h07jonas/SYNCHRO/Hardware/BOM_SYNCHRO.md

|**Name**|**Anzahl**|**Bestellnummer**|**Lieferant**|
|-|-|-|-|
|ESP32-S3-WROOM1-N8R8|1|356-EP32S3WROOM1N8R8|mouser|
|Keramikkondensator 0.1uF X7R 1206|1|77-VJ1206Y104KXXMT|mouser|
|Keramikkondensator 1uF X7R 1206|1|77-VJ1206Y105KLXAJ32|mouser|
|Keramikkondensator 22uF X7R 1210|1|963-MAAST32MSB7226MP|mouser|
|Dickfilmwiderstände SMD 0805 1% 10kOhms 1/8W|2|603-RE0805FRE1010KL|mouser|
|USB 2.0 B Type|1|523-GSB22120RSKEU|mouser|
|DC/DC-Wandler – Durchsteckmontage 3.3V 500mA|1|919-R-78E3.3-0.5|mouser|
|Keramikkondensator 10uF X7R 1210|1|963-TMK325AB7106KMPR|mouser|
|Leitungstreiber Non-inverting Octal Bus|2|863-C74VHCT541ADWR2G|mouser|
|DC/DC-Wandler – Durchsteckmontage 8-28Vin 5V 1.0A THRU|1|919-R-78E5.0-1.0|mouser|
|AC-Adapter 12V 1A|1|490-SWI12-12-E-P5|mouser|
|DC-Spannungsversorgungssteckverbinder|1|710-694106301002|mouser|
|LDO Spannungs-Regulator LDO BJT HiCurr 3.3V 1A|1|621-AZ1117CH-3.3TRG1|mouser|
|Schottky Diode|1|771-PMEG3010ER-QX|mouser|
|XH Header Sockel|8|306-B4BXHALFSN|mouser|
