h07jonas/SYNCHRO/Docs/BOM_SYNCHRO_Booster.xlsx

Projekt: | SYNCHRO | Baugruppe: | Booster | Baugruppennr.: | 1.0
Ersteller: | Jonas Henz | Revision: | v1.0 | Status: | Entwurf
Anzahl Baugruppen: | 6 | Datum: | 2026-08-25
Reference | Qty | Gesamtmenge | Bestellmenge | Bestellnummer | Link | Lieferant | Value | Footprint | Datasheet
C1,C9,C10,C11,C12 | 5 | 30 | 40 | 77-VJ1206Y104KXXMT | https://www.mouser.ch/en/ProductDetail/Vishay-Vitramon/VJ1206Y104KXXMT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 | Mouser | Capacitor_THT:C_Disc_D5.0mm_W2.5mm_P5.00mm | Capacitor_THT:C_Disc_D5.0mm_W2.5mm_P5.00mm
C2,C3 | 2 | 12 | 15 | 667-EEU-FM1V471 | https://www.mouser.ch/en/ProductDetail/Panasonic-Industry/EEU-FM1V471?qs=4F1vP4lJYtGxZCTadysVhQ%3D%3D | Mouser | Capacitor_THT:CP_Radial_D10.0mm_P5.00mm | Capacitor_THT:CP_Radial_D10.0mm_P5.00mm
C4 | 1 | 6 | 10 | 80-C317C103K1R | https://www.mouser.ch/en/ProductDetail/KEMET/C317C103K1R5TA?qs=wGiHhy9sa2PnfI8By%252BZbyA%3D%3D | Mouser | Capacitor_THT:C_Disc_D5.0mm_W2.5mm_P5.00mm | Capacitor_THT:C_Disc_D5.0mm_W2.5mm_P5.00mm
C5,C6,C7 | 3 | 18 | 20 | 505-MKS20.022/63/5 | https://www.mouser.ch/en/ProductDetail/WIMA/MKS2C022201A00JSSD?qs=ISKKXg98%252B1kXZo2DGjqt1Q%3D%3D | Mouser | Capacitor_THT:C_Rect_L7.0mm_W2.5mm_P5.00mm | Capacitor_THT:C_Rect_L7.0mm_W2.5mm_P5.00mm
C8 | 1 | 6 | 10 | 667-EEU-HD1H100B | https://www.mouser.ch/en/ProductDetail/Panasonic-Industry/EEU-HD1H100B?qs=RSvpxwwo2RNa75zii2se%2FA%3D%3D | Mouser | Capacitor_THT:C_Rect_L7.0mm_W2.5mm_P5.00mm | Capacitor_THT:C_Rect_L7.0mm_W2.5mm_P5.00mm
D1,D2 | 2 | 12 | 20 | 512-1N4148 | https://www.mouser.ch/en/ProductDetail/onsemi/1N4148?qs=i4Fj9T%2FoRm8RMUhj5DeFQg%3D%3D | Mouser | Diode_THT:D_DO-35_SOD27_P7.62mm_Horizontal | Diode_THT:D_DO-35_SOD27_P7.62mm_Horizontal | https://assets.nexperia.com/documents/data-sheet/1N4148_1N4448.pdf
D3 | 1 | 6 | 10 | 625-SMAJ16CA-E3 | https://www.mouser.ch/en/ProductDetail/Vishay-Semiconductors/SMAJ16CA-E3-61?qs=nE2yEqgPWzdYDq2yTw6oFA%3D%3D | Mouser | Diode_SMD:D_SMA-SMB_Universal_Handsoldering | Diode_SMD:D_SMA-SMB_Universal_Handsoldering | https://www.littelfuse.com/media?itemid=75e32973-b177-4ee3-a0ff-cedaf1abdb93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
D4,D5 | 2 | 12 | x | vorhanden |  |  | LED_THT:LED_D5.0mm | LED_THT:LED_D5.0mm
F1 | 1 | 6 | 10 | 652-MFR185 | https://www.mouser.ch/en/ProductDetail/Bourns/MF-R185?qs=2bTIwLLrckQD2gvRTyQH8A%3D%3D | Mouser | SYNCHRO_Library:Fuse_Bourns_MF-R185 | SYNCHRO_Library:Fuse_Bourns_MF-R185
IC1 | 1 | 6 | 6 | 511-L6203 | https://www.mouser.ch/en/ProductDetail/STMicroelectronics/L6203?qs=gr8Zi5OG3MivQB7QgTa84w%3D%3D | Mouser | SYNCHRO_Library:MULTIWATT-11 | SYNCHRO_Library:MULTIWATT-11
J1,J2 | 2 | 12 | 12 | 651-1711725 | https://www.mouser.ch/en/ProductDetail/Phoenix-Contact/1711725?qs=F79NelsxgYFLEb9U5DotcA%3D%3D | Mouser | TerminalBlock_Phoenix:TerminalBlock_Phoenix_MKDS-1,5-2-5.08_1x02_P5.08mm_Horizontal | TerminalBlock_Phoenix:TerminalBlock_Phoenix_MKDS-1,5-2-5.08_1x02_P5.08mm_Horizontal
J3 | 1 | 6 | 20 | 306-B4BXHALFSN | https://www.mouser.ch/en/ProductDetail/JST-Commercial/B4B-XH-ALFSN?qs=cdbOS8ANM9CfC08d%252BywhFw%3D%3D | Mouser | SYNCHRO_Library:JST_B4B-XH-A_LF__SN_ | SYNCHRO_Library:JST_B4B-XH-A_LF__SN_
J4 | 1 | 6 | x | vorhanden |  |  | Messpunkt | Messpunkt
PS1 | 1 | 6 | 8 | 919-R-78E5.0-0.5 | https://www.mouser.ch/en/ProductDetail/RECOM-Power/R-78E5.0-0.5?qs=JeAkOuORR2UvBuiB2kZVZQ%3D%3D | Mouser | SYNCHRO_Library:CONV_R-78E5.0-0.5 | SYNCHRO_Library:CONV_R-78E5.0-0.5
R1 | 1 | 6 | 10 | 756-LRMAP2512R10FT4 | https://www.mouser.ch/en/ProductDetail/Welwyn-Components-TT-Electronics/LRMAP2512-R10FT4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 | Mouser | Resistor_SMD:R_2512_6332Metric_Pad1.40x3.35mm_HandSolder | Resistor_SMD:R_2512_6332Metric_Pad1.40x3.35mm_HandSolder | LRMAP2512-R10FT4.
R2,R4,R12,R13 | 4 | 24 | x | vorhanden |  |  | Resistor_SMD:R_0805_2012Metric_Pad1.20x1.40mm_HandSolder | Resistor_SMD:R_0805_2012Metric_Pad1.20x1.40mm_HandSolder
R3 | 1 | 6 | x | vorhanden |  |  | Resistor_SMD:R_0805_2012Metric_Pad1.20x1.40mm_HandSolder | Resistor_SMD:R_0805_2012Metric_Pad1.20x1.40mm_HandSolder
R5,R9,R10 | 3 | 18 | x | vorhanden |  |  | Resistor_SMD:R_0805_2012Metric_Pad1.20x1.40mm_HandSolder | Resistor_SMD:R_0805_2012Metric_Pad1.20x1.40mm_HandSolder
R6 | 1 | 6 | x | vorhanden |  |  | Resistor_SMD:R_0805_2012Metric_Pad1.20x1.40mm_HandSolder | Resistor_SMD:R_0805_2012Metric_Pad1.20x1.40mm_HandSolder
R7,R8 | 2 | 12 | x | vorhanden |  |  | Resistor_SMD:R_0805_2012Metric_Pad1.20x1.40mm_HandSolder | Resistor_SMD:R_0805_2012Metric_Pad1.20x1.40mm_HandSolder
R11 | 1 | 6 | x | vorhanden |  |  | Resistor_SMD:R_0805_2012Metric_Pad1.20x1.40mm_HandSolder | Resistor_SMD:R_0805_2012Metric_Pad1.20x1.40mm_HandSolder
SW1 | 1 | 6 | x | vorhanden |  |  | Button_Switch_THT:SW_PUSH_6mm | Button_Switch_THT:SW_PUSH_6mm
SW2 | 1 | 6 | 6 | 651-1711738 | https://www.mouser.ch/en/ProductDetail/Phoenix-Contact/1711738?qs=F79NelsxgYGJoCQSSUE92w%3D%3D | Mouser | TerminalBlock_Phoenix:TerminalBlock_Phoenix_MKDS-3-3-5.08_1x03_P5.08mm_Horizontal | TerminalBlock_Phoenix:TerminalBlock_Phoenix_MKDS-3-3-5.08_1x03_P5.08mm_Horizontal
U1 | 1 | 6 | 10 | 595-LM393P | https://www.mouser.ch/en/ProductDetail/Texas-Instruments/LM393P?qs=1K8%2FAQHn5WT5g4otW1rg%2Fg%3D%3D | Mouser | SYNCHRO_Library:DIP762W50P254L977H451Q8 | SYNCHRO_Library:DIP762W50P254L977H451Q8
U2,U3 | 2 | 12 | 20 | 859-6N137 | https://www.mouser.ch/en/ProductDetail/LITEON/6N137?qs=PByDJ0nQNwo227Fz%2Fg9MJA%3D%3D | Mouser | SYNCHRO_Library:DIP762W50P254L977H451Q8 | SYNCHRO_Library:DIP762W50P254L977H451Q8
U4 | 1 | 6 | 10 | 771-LVC2G02DC125 | https://www.mouser.ch/en/ProductDetail/Nexperia/74LVC2G02DC125?qs=me8TqzrmIYUWhTHaIlO9Yw%3D%3D | Mouser | Package_SO:VSSOP-8_2.3x2mm_P0.5mm | Package_SO:VSSOP-8_2.3x2mm_P0.5mm | http://www.ti.com/lit/sg/scyt129e/scyt129e.pdf
 |  |  |  |  |  | Gesamtpreis pro Baugruppe: | 0
 |  |  |  |  |  | Gesamtpreis Total: | 0
