h07jonas/SYNCHRO/Docs/SYNCHRO_BOM_Zentrale_Booster.xlsx

Sheet: SYNCHRO Zentrale
SYNCHRO Zentrale – Modul-Stückliste
Projekt: SYNCHRO Zentrale | 0805 SMD-Widerstände zusammengefasst | Mouser Bestellnummern & Richtpreise
Pos | Designator | Menge | Wert / Typ | Beschreibung | Bauform / Gehäuse | Mouser Bestellnummer | Hersteller-Teilenummer | Stückpreis (CHF) | Gesamtpreis (CHF) | Lieferant
1 | U1 | 1 | ESP32-S3-WROOM-1-N8R8 | Mikrocontroller Modul Wi-Fi / BLE (8MB Flash, 8MB PSRAM) | SMD Modul | 356-EP32S3WROOM1N8R8 | ESP32-S3-WROOM-1-N8R8 | 5.40 CHF |  | Mouser
2 | IC1, IC2 | 2 | MC74VHCT541ADWR2G | Octal Bus Buffer / Line Driver Non-Inverting 3-State | SOIC-20 | 863-C74VHCT541ADWR2G | MC74VHCT541ADWR2G | 0.96 CHF |  | Mouser
3 | IC3 | 1 | AZ1117CH-3.3TRG1 | LDO Spannungsregler 3.3V 1A | SOT-223 | 621-AZ1117CH-3.3TRG1 | AZ1117CH-3.3TRG1 | 0.48 CHF |  | Mouser
4 | PS1 | 1 | R-78E3.3-0.5 | DC/DC-Schaltregler 3.3V 500mA SIP-3 | SIP-3 THT | 919-R-78E3.3-0.5 | R-78E3.3-0.5 | 2.65 CHF |  | Mouser
5 | PS2 | 1 | R-78E5.0-1.0 | DC/DC-Schaltregler 5.0V 1.0A SIP-3 | SIP-3 THT | 919-R-78E5.0-1.0 | R-78E5.0-1.0 | 3.41 CHF |  | Mouser
6 | D1 | 1 | PMEG3010ER | Schottky-Diode 30V 1A Low Vf | SOD-123W (CFP3) | 771-PMEG3010ER-QX | PMEG3010ER,115 | 0.38 CHF |  | Mouser
7 | D2, D3, D4, D5, D6, D7 | 6 | LED | Standard Signal-LED 5mm THT | LED 5.0mm Radial | 604-WP7113GD | WP7113GD | 0.28 CHF |  | Mouser
8 | C1, C12 | 2 | 22uF | Keramikkondensator 22µF 16V/25V X7R | 1210 SMD | 963-MAAST32MSB7226MP | EMK325B7226MM-TR | 0.85 CHF |  | Mouser
9 | C2, C4, C7, C8 | 4 | 100nF / 0.1uF | Keramikkondensator 100nF 50V X7R | 1206 SMD | 77-VJ1206Y104KXXMT | VJ1206Y104KXXMT | 0.22 CHF |  | Mouser
10 | C3 | 1 | 1uF | Keramikkondensator 1µF 50V X7R | 1206 SMD | 77-VJ1206Y105KLXAJ32 | VJ1206Y105KLXAJ32 | 0.35 CHF |  | Mouser
11 | C5, C6, C9, C10, C11 | 5 | 10uF | Keramikkondensator 10µF 25V X7R | 1210 SMD | 963-TMK325AB7106KMPR | TMK325AB7106KMPR | 0.65 CHF |  | Mouser
12 | R1 .. R12 | 12 | 0805 SMD Widerstände | SMD-Widerstände 0805 1% (6x 10k, 5x 220R, 1x 470R) | 0805 SMD | 603-RC0805FR-Serie | RC0805FR-Serie | 0.08 CHF |  | Mouser
13 | SW1, SW2, SW3, SW4, SW5, SW6 | 6 | SW_Push | Kurzhubtaster 6x6mm THT H=4.3mm/5mm | Button 6x6mm THT | 688-SKHHBY004A | SKHHBY004A | 0.32 CHF |  | Mouser
14 | J1 | 1 | GSB22120RSKEU | USB 2.0 Typ-B Buchse Printmontage | USB-B THT | 523-GSB22120RSKEU | GSB22120RSKEU | 1.45 CHF |  | Mouser
15 | J2, J3, J4, J5, J6, J7, J8, J9 | 8 | B4B-XH-A_LF__SN_ | JST XH Stiftwanne 4-polig RM 2.50mm | JST XH 4-Pin RM 2.50mm | 306-B4BXHALFSN | B4B-XH-A(LF)(SN) | 0.25 CHF |  | Mouser
16 | J10 | 1 | 694106301002 | DC-Hohlstecker-Buchse 2.1mm / 5.5mm | DC-Power Jack 2.1mm | 710-694106301002 | 694106301002 | 1.10 CHF |  | Mouser
17 | J11 | 1 | Conn_01x06 | Stiftleiste 1x6-polig RM 2.54mm gerade | Pin Header 1x06 RM2.54 | 517-961106-6404-AR | 961106-6404-AR | 0.45 CHF |  | Mouser
18 | Zubehör | 1 | SWI12-12-E-P5 | AC/DC Steckernetzteil 12V 1A Eurostecker (Zubehör) | Wall Adapter | 490-SWI12-12-E-P5 | SWI12-12-E-P5 | 11.20 CHF |  | Mouser
TOTAL ZENTRALE:

Sheet: SYNCHRO Booster
SYNCHRO Booster – Modul-Stückliste
Projekt: SYNCHRO Booster | 0805 SMD-Widerstände zusammengefasst | Mouser Bestellnummern & Richtpreise
Pos | Designator | Menge | Wert / Typ | Beschreibung | Bauform / Gehäuse | Mouser Bestellnummer | Hersteller-Teilenummer | Stückpreis (CHF) | Gesamtpreis (CHF) | Lieferant
1 | IC1 | 1 | L6203 | DMOS Vollbrücken-Treiber 4A 52V | MULTIWATT-11 | 511-L6203 | L6203 | 9.94 CHF |  | Mouser
2 | U1 | 1 | LM393P | Dualer Komparator Low-Power | DIP-8 | 595-LM393P | LM393P | 0.65 CHF |  | Mouser
3 | U2, U3 | 2 | 6N137 | High-Speed Optokoppler 10 MBd Open-Collector | DIP-8 | 782-6N137 | 6N137 | 1.15 CHF |  | Mouser
4 | U4 | 1 | 74LVC2G02 | Dual 2-Input NOR-Gatter (SN74LVC2G02DCUR) | VSSOP-8 | 595-SN74LVC2G02DCUR | SN74LVC2G02DCUR | 0.45 CHF |  | Mouser
5 | PS1 | 1 | R-78E5.0-0.5 | DC/DC-Schaltregler 5.0V 500mA SIP-3 | SIP-3 THT | 919-R-78E5.0-0.5 | R-78E5.0-0.5 | 2.65 CHF |  | Mouser
6 | D1, D2 | 2 | 1N4148 | Standard-Schaltdiode 100V 200mA | DO-35 THT | 512-1N4148 | 1N4148 | 0.12 CHF |  | Mouser
7 | D3 | 1 | SMAJ16CA-E3/61 | TVS-Diode Bidirektional 16V 400W | SMA (DO-214AC) | 625-SMAJ16CA-E3/61 | SMAJ16CA-E3/61 | 0.42 CHF |  | Mouser
8 | D4, D5 | 2 | LED | Standard Signal-LED 5mm THT | LED 5.0mm Radial | 604-WP7113GD | WP7113GD | 0.28 CHF |  | Mouser
9 | F1 | 1 | MF-R185-2-99 | PTC-Sicherung PolySwitch rückstellbar 1.85A | Radial THT | 652-MF-R185-2-99 | MF-R185-2-99 | 0.85 CHF |  | Mouser
10 | C1, C9..C12 | 5 | 100nF | Keramikkondensator 100nF 50V X7R THT | Radial D5.0mm RM5.0 | 80-C315C104K5R5TA | C315C104K5R5TA | 0.25 CHF |  | Mouser
11 | C2, C3 | 2 | 470uF | Elektrolytkondensator Radial 470µF 35V Low-ESR | Radial D10mm RM5.0 | 667-EEU-FR1V471 | EEU-FR1V471 | 0.72 CHF |  | Mouser
12 | C4 | 1 | 10nF | Keramikkondensator 10nF 50V X7R THT | Radial D5.0mm RM5.0 | 80-C315C103K5R5TA | C315C103K5R5TA | 0.20 CHF |  | Mouser
13 | C5, C6, C7 | 3 | 22nF 50V | Folienkondensator MKS 22nF 63V/50V RM5.0 | Rect THT RM5.0 | 505-MKS20.022/63/10 | MKS2C022201A00KSSD | 0.55 CHF |  | Mouser
14 | C8 | 1 | 10uF 50V | Folienkondensator / MLCC 10µF 50V RM5.0 | Rect THT RM5.0 | 80-C330C106M5U5TA | C330C106M5U5TA | 0.95 CHF |  | Mouser
15 | R1 | 1 | 100m | Shunt-Messwiderstand 100mΩ 1% 2W SMD 2512 | 2512 SMD | 71-LRMAP2512-R10FT4 | LRMAP2512-R10FT4 | 0.95 CHF |  | Mouser
16 | R2 .. R13 | 11 | 0805 SMD Widerstände | SMD-Widerstände 0805 1% (4x 1k, 1x 24k, 3x 4.7k, 1x 10R, 2x 1.2k, 1x 10k) | 0805 SMD | 603-RC0805FR-Serie | RC0805FR-Serie | 0.08 CHF |  | Mouser
17 | SW1 | 1 | SW_Push | Kurzhubtaster 6x6mm THT H=4.3mm/5mm | Button 6x6mm THT | 688-SKHHBY004A | SKHHBY004A | 0.32 CHF |  | Mouser
18 | SW2 | 1 | SW_SPDT | Phoenix Schraubklemme 3-polig RM 5.08mm | Terminal Block RM 5.08mm | 651-1711738 | 1711738 | 1.35 CHF |  | Mouser
19 | J1, J2 | 2 | Conn_01x02_Pin / Power | Phoenix Schraubklemme 2-polig RM 5.08mm | Terminal Block RM 5.08mm | 651-1715721 | 1715721 | 0.95 CHF |  | Mouser
20 | J3 | 1 | B4B-XH-A | JST XH Stiftwanne 4-polig RM 2.50mm | JST XH 4-Pin RM 2.50mm | 306-B4BXHALFSN | B4B-XH-A(LF)(SN) | 0.25 CHF |  | Mouser
21 | J4 | 1 | Messpunkt | Prüfpunkt / Test Point PCB Miniatur THT | Test Point THT | 534-5001 | 5001 | 0.35 CHF |  | Mouser
TOTAL BOOSTER:
