h07jonas/SYNCHRO/Hardware/SYNCHRO_Zentrale/BOM_SYNCHRO_Zentrale.xlsx

Reference | Qty | Bestellnummer | Lieferant | Value | Footprint | Datasheet
C1,C12 | 2 | 963-MAAST32MSB7226MP | Mouser | Capacitor_SMD:C_1210_3225Metric_Pad1.33x2.70mm_HandSolder | Capacitor_SMD:C_1210_3225Metric_Pad1.33x2.70mm_HandSolder
C2,C4 | 2 | 77-VJ1206Y104KXXMT | Mouser | Capacitor_SMD:C_1206_3216Metric_Pad1.33x1.80mm_HandSolder | Capacitor_SMD:C_1206_3216Metric_Pad1.33x1.80mm_HandSolder
C3 | 1 | 77-VJ1206Y105KLXAJ32 | Mouser | Capacitor_SMD:C_1206_3216Metric_Pad1.33x1.80mm_HandSolder | Capacitor_SMD:C_1206_3216Metric_Pad1.33x1.80mm_HandSolder
C5,C6,C9,C10,C11 | 5 | 963-TMK325AB7106KMPR | Mouser | Capacitor_SMD:C_1210_3225Metric_Pad1.33x2.70mm_HandSolder | Capacitor_SMD:C_1210_3225Metric_Pad1.33x2.70mm_HandSolder
C7,C8 | 2 | 77-VJ1206Y104KXXMT | Mouser | Capacitor_SMD:C_1206_3216Metric_Pad1.33x1.80mm_HandSolder | Capacitor_SMD:C_1206_3216Metric_Pad1.33x1.80mm_HandSolder
D1 | 1 | 771-PMEG3010ER-QX | Mouser | Diode_SMD:Nexperia_CFP3_SOD-123W | Diode_SMD:Nexperia_CFP3_SOD-123W
IC1,IC2 | 2 | 863-C74VHCT541ADWR2G | Mouser | SYNCHRO_Library:SOIC127P1030X265-20N | SYNCHRO_Library:SOIC127P1030X265-20N | https://www.onsemi.com/pub/Collateral/MC74VHC541-D.PDF
IC3 | 1 | 621-AZ1117CH-3.3TRG1 | Mouser | SYNCHRO_Library:SOT230P700X180-4N | SYNCHRO_Library:SOT230P700X180-4N | https://www.diodes.com//assets/Datasheets/AZ1117C.pdf
J1 | 1 | 523-GSB22120RSKEU | Mouser | SYNCHRO_Library:AMPHENOL_GSB22120RSKEU | SYNCHRO_Library:AMPHENOL_GSB22120RSKEU
J2,J3,J4,J5,J6,J7,J8,J9 | 8 | 306-B4BXHALFSN | Mouser | SYNCHRO_Library:JST_B4B-XH-A_LF__SN_ | SYNCHRO_Library:JST_B4B-XH-A_LF__SN_
J10 | 1 | 710-694106301002 | Mouser | SYNCHRO_Library:694106301002 | SYNCHRO_Library:694106301002 | https://www.we-online.com/catalog/datasheet/694106301002.pdf
J11 | 1 |  |  | Conn_01x06 | Conn_01x06
PS1 | 1 | 919-R-78E3.3-0.5 | Mouser | SYNCHRO_Library:CONV_R-78E3.3-0.5 | SYNCHRO_Library:CONV_R-78E3.3-0.5
PS2 | 1 | 919-R-78E5.0-1.0 | Mouser | SYNCHRO_Library:R78E5010 | SYNCHRO_Library:R78E5010 | http://www.recom-power.com/pdf/Innoline/R-78Exx-1.0.pdf
U1 | 1 | 356-EP32S3WROOM1N8R8 | Mouser | SYNCHRO_Library:ESP32S3WROOM1N8R8 | SYNCHRO_Library:ESP32S3WROOM1N8R8
R1,R2,R3,R4,R5,R6 | 6 |  |  | Resistor_SMD:R_0805_2012Metric_Pad1.20x1.40mm_HandSolder | Resistor_SMD:R_0805_2012Metric_Pad1.20x1.40mm_HandSolder
R7,R8,R9,R10,R11 | 5 |  |  | Resistor_SMD:R_0805_2012Metric_Pad1.20x1.40mm_HandSolder | Resistor_SMD:R_0805_2012Metric_Pad1.20x1.40mm_HandSolder
R12 | 1 |  |  | Resistor_SMD:R_0805_2012Metric_Pad1.20x1.40mm_HandSolder | Resistor_SMD:R_0805_2012Metric_Pad1.20x1.40mm_HandSolder
SW1,SW2,SW3,SW4,SW5,SW6 | 6 |  |  | Button_Switch_THT:SW_PUSH_6mm | Button_Switch_THT:SW_PUSH_6mm
D2,D3,D4,D5,D6,D7 | 6 |  |  | LED_THT:LED_D5.0mm | LED_THT:LED_D5.0mm
 |  |  |  |  | Gesamtpreis pro Baugruppe: | 0
 |  |  |  |  | Gesamtpreis Total: | 0
 |  |  |  |  | Projekt: | SYNCHRO | Baugruppe: | DNP | Baugruppennr.: | Zentrale
 |  |  |  |  | Ersteller: | Jonas Henz | Revision: | v1.0 | Status: | Entwurf
 |  |  |  |  | Anzahl Baugruppen: | 1 | Datum: | 2026-08-25
