h07jonas/SYNCHRO/Docs/SYNCHRO_Projekt_Gesamtkosten_Kalkulation.xlsx

SYNCHRO Modellbahnsteuerung – Gesamtkostenkalkulation
Projektumfang: 1x Zentrale, 5x Standard-Booster, 1x Prototyp-Booster | Inkl. Leiterplatten, Gehäuse & Stromversorgung
Pos | Kategorie / Hauptkomponente | Beschreibung & Enthaltene Komponenten | Menge | Einheit | Geschätzter Richtpreis | Gesamtbetrag | Lieferant / Quelle
1.0 SYNCHRO ZENTRALE (1 Stück)
1.1 | Haupt-Mikrocontroller | ESP32-S3-WROOM-1-N8R8 (8MB Flash, 8MB PSRAM) | 1 | Stk. | 6.00 CHF | 6.00 CHF | Mouser
1.2 | Logik & Bus-Treiber | 2x MC74VHCT541A Octal Buffer SOIC-20 | 1 | Satz | 2.50 CHF | 2.50 CHF | Mouser
1.3 | Spannungsversorgung Platine | R-78E5.0-1.0, R-78E3.3-0.5, AZ1117 LDO, Schottky-Diode | 1 | Satz | 8.00 CHF | 8.00 CHF | Mouser
1.4 | Kondensatoren & Passivbauteile | 14x Keramikkondensatoren (1206/1210: 22µF, 10µF, 1µF, 100nF) | 1 | Satz | 6.50 CHF | 6.50 CHF | Mouser
1.5 | SMD-Widerstände 0805 | 12x SMD-Widerstände 0805 1% (10k, 220R, 470R) | 1 | Satz | 1.50 CHF | 1.50 CHF | Mouser
1.6 | Steckverbinder, Taster & LEDs | 8x JST-XH 4-Pin, USB-B Buchse, DC-Buchse, 6x Taster, 6x LEDs, Stiftleiste | 1 | Satz | 8.50 CHF | 8.50 CHF | Mouser
1.7 | Zentrale-Netzteil (Zubehör) | CUI 12V 1A AC/DC Steckernetzteil (Eurostecker) | 1 | Stk. | 12.00 CHF | 12.00 CHF | Mouser
2.0 SYNCHRO STANDARD-BOOSTER (5 Stück)
2.1 | H-Brücken Leistungstreiber | 5x L6203 DMOS Vollbrücken-Treiber 4A 52V (MULTIWATT-11) | 5 | Stk. | 10.50 CHF | 52.50 CHF | Mouser
2.2 | Kühlkörper Leistungstreiber | 5x Aufsteckkühlkörper für Multiwatt-11 Gehäuse | 5 | Stk. | 2.00 CHF | 10.00 CHF | Mouser / Distrelec
2.3 | Optokoppler & Komparator Logik | 10x 6N137 High-Speed Optokoppler, 5x LM393, 5x 74LVC2G02 | 5 | Satz | 4.00 CHF | 20.00 CHF | Mouser
2.4 | Booster Stromversorgung Platine | 5x R-78E5.0-0.5 DC/DC-Schaltregler, TVS- & Schutzdioden | 5 | Satz | 4.00 CHF | 20.00 CHF | Mouser
2.5 | Kondensatoren & Elkos | 10x 470µF Elkos, 25x 100nF THT, Folienkondensatoren (22nF, 10µF) | 5 | Satz | 5.00 CHF | 25.00 CHF | Mouser
2.6 | Widerstände & Shunts | 5x 100mΩ 2512 Shunts + 55x SMD-Widerstände 0805 (10R bis 24k) | 5 | Satz | 2.00 CHF | 10.00 CHF | Mouser
2.7 | Klemmen, PTCs, Taster & LEDs | 10x Phoenix 2p, 5x Phoenix 3p, 5x JST-XH, 5x PTC 1.85A, Taster & LEDs | 5 | Satz | 5.00 CHF | 25.00 CHF | Mouser
3.0 SPEZIELLER BOOSTER PROTOTYP (1 Stück)
3.1 | Prototyp-Bauteilsatz | Komplettsatz Bauteile (Leistungstreiber, Optokoppler, Passiv, Klemmen, Kühlkörper) | 1 | Satz | 32.00 CHF | 32.00 CHF | Mouser
4.0 LEITERPLATTEN-FERTIGUNG (PCB Batches)
4.1 | PCB Zentrale (Batch 5 Stk.) | 2-Layer FR4 1.6mm HASL lead-free (1 verwendet, 4 Reserve) | 1 | Batch | 4.00 CHF | 4.00 CHF | JLCPCB / PCBWay
4.2 | PCB Booster (Batch 5 Stk.) | 2-Layer FR4 1.6mm HASL lead-free (5 verwendet) | 1 | Batch | 4.00 CHF | 4.00 CHF | JLCPCB / PCBWay
4.3 | PCB Prototyp (Batch 5 Stk.) | 2-Layer FR4 1.6mm HASL lead-free (1 verwendet, 4 Reserve) | 1 | Batch | 4.00 CHF | 4.00 CHF | JLCPCB / PCBWay
4.4 | Express-Versand & Verzollung PCBs | Kombinierter DHL Express Versand + Einfuhr/Handling Schweiz | 1 | Pauschal | 24.00 CHF | 24.00 CHF | Spediteur / DHL
5.0 HAUPTSTROMVERSORGUNG & GEHÄUSE (3D-DRUCK)
5.1 | Gleisstrom-Hauptnetzteil | MeanWell LRS-350-15 Schaltnetzteil (15V DC / 23.2A / 350W) | 1 | Stk. | 35.00 CHF | 35.00 CHF | Mouser / Distrelec
5.2 | 3D-Druck Gehäuse (PLA) | 7x Gehäuseunterteil & Deckel (ca. 550g PLA Filament) | 1 | Pauschal | 16.00 CHF | 16.00 CHF | Filamentbestand
5.3 | 3D-Druck Frontblenden (Resin) | 7x Frontplatten / Lichtleiter / Tasterführungen (ca. 200ml Resin) | 1 | Pauschal | 10.00 CHF | 10.00 CHF | Resinbestand
5.4 | Montagematerial & Puffer | Schrauben M3/M2.5, Gummifüsse, Litzen, Puffer für Kleinteile | 1 | Pauschal | 15.00 CHF | 15.00 CHF | Werkstatt
GESAMTSUMME PROJEKT: |  |  |  |  |  | 351.50 CHF
