h07jonas/SYNCHRO/Hardware/SYNCHRO_Booster/v3.0/SYNCHRO_Booster.step

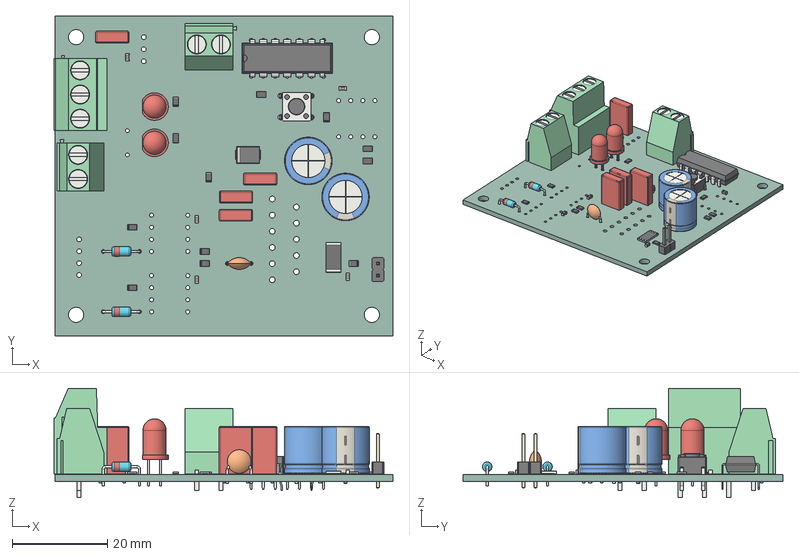
[picture p16: CAD file, 2026-10-20]
Hardware/SYNCHRO_Booster/v3.0/SYNCHRO_Booster.step
71.3 x 67.3 x 23.0 mm
C_0603_1608Metric x 5
R_0805_2012Metric x 12
D_SMB
TerminalBlock_Phoenix_MKDS-1,5-2-5.08_1x02_P5.08mm_Horizontal x 2
CP_Radial_D100mm_P500mm x 2
C_Rect_L70mm_W25mm_P500mm x 4
LED_D5.0mm x 2
R_2512_6332Metric
TerminalBlock_Phoenix_MKDS-3-3-5.08_1x03_P5.08mm_Horizontal
DIP-14_W7.62mm
C_Disc_D50mm_W25mm_P500mm
D_DO-35_SOD27_P7.62mm_Horizontal x 2
SW_PUSH_6mm
PinHeader_1x02_P254mm_Vertical
SYNF486_PCB
