h07jonas/SYNCHRO/Hardware/SYNCHRO_Zentrale/SYNCHRO_Zentrale_sch.pdf

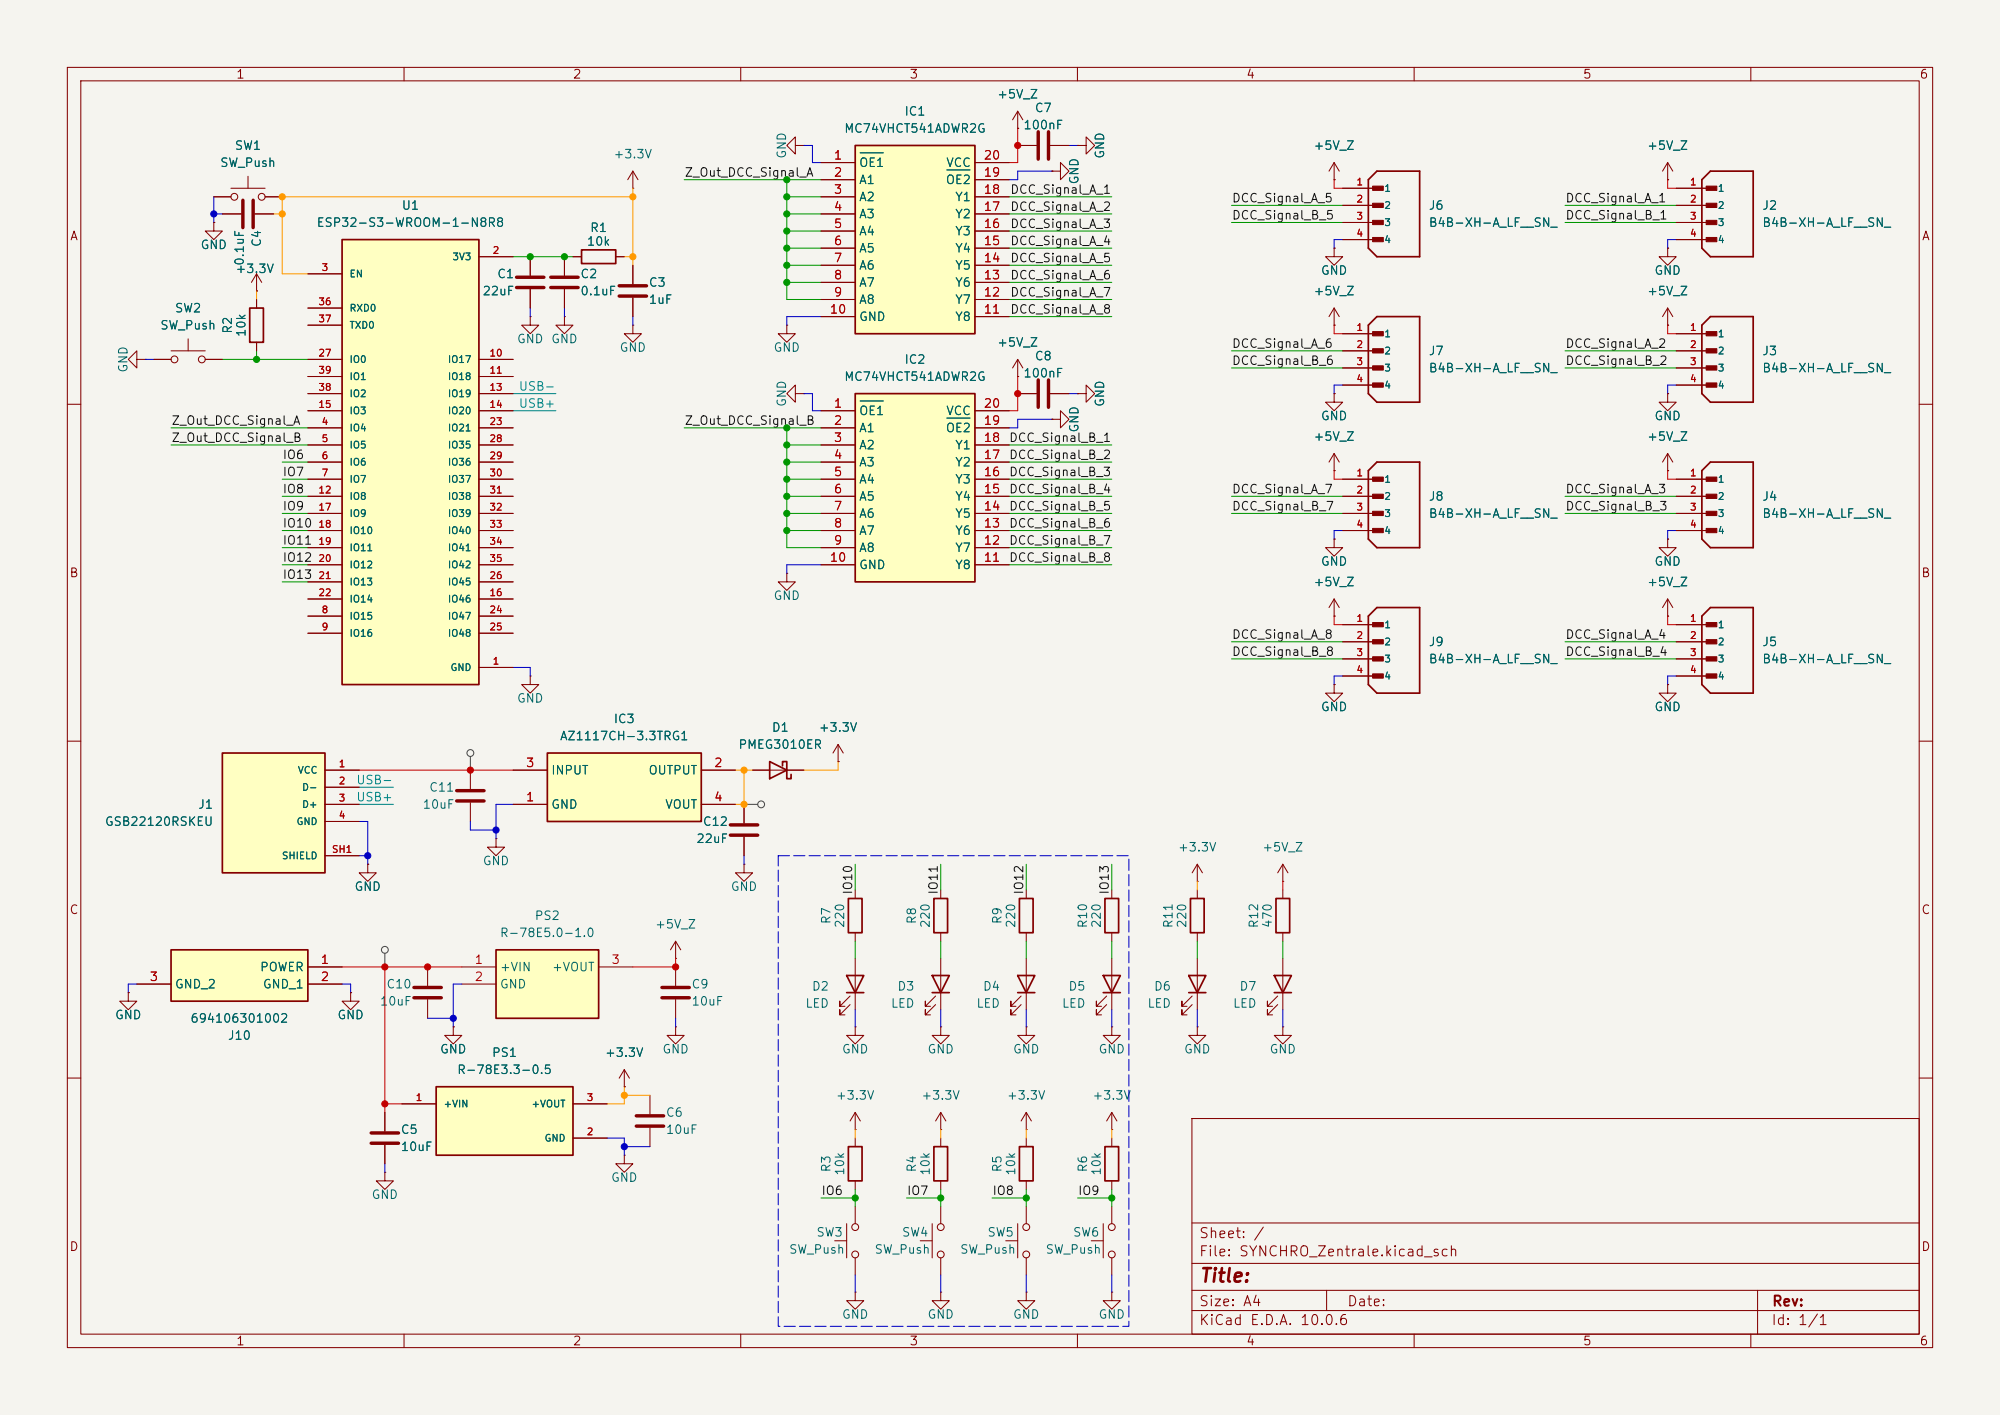
[picture p17: page 1]

A4 5 | DCC_Signal_A_3
A5 6 | DCC_Signal_A_4

Size: A4 | Rev:
KiCad E.D.A. 10.0.6 | Id: 1/1
