h07jonas/SYNCHRO/Hardware/SYNCHRO_Booster/v2.0_FlipFlop_only/SYNCHRO_Booster_sch.pdf

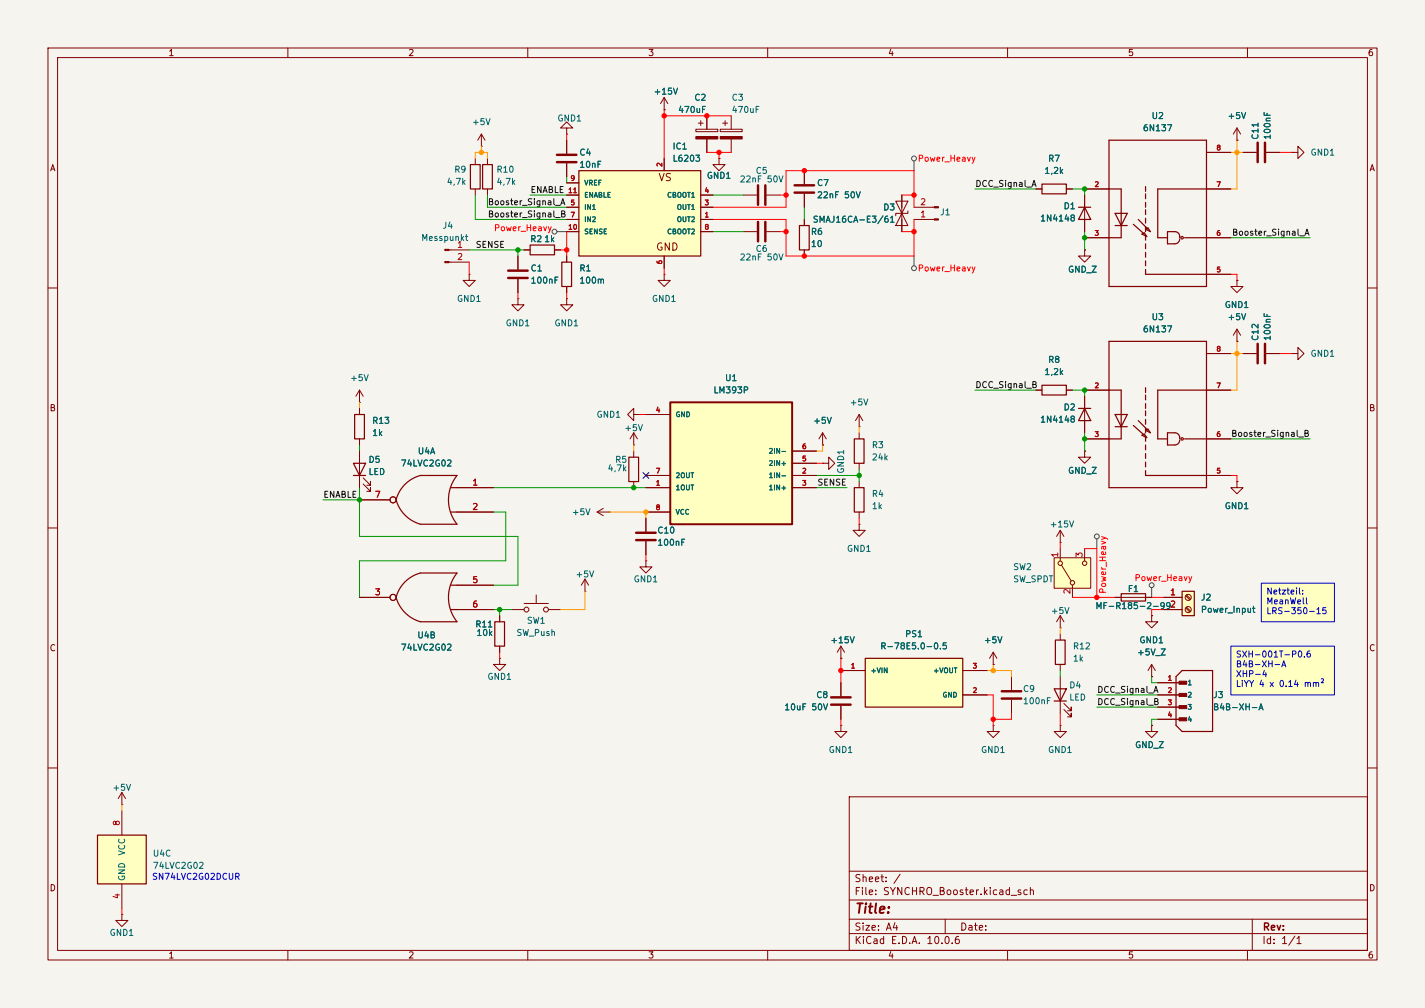
[picture p18: page 1]

Size: A4 | Rev:
KiCad E.D.A. 10.0.6 | Id: 1/1
