h07jonas/SYNCHRO/Hardware/LTSpice/Draft1.asc

C1: cap; 10n
C2: cap; 10n
R1: res; 16k
R2: res; 16k
R3: res; 1.6k
R4: res; 1.6k
U1: UniversalOpAmp2
U2: UniversalOpAmp2
V1: voltage; 5
V2: voltage; 5
V3: voltage; ""; AC 1
Named nets: Ua1, 0, +5V, -5V, Ue, Ua2
.tran 1
.ac dec 100 10 1000k
