h07jonas/SYNCHRO/Hardware/LTSpice/DCC_Booster_Test_V1.0.asc

A1: or; Vhigh=5 Vf=0
A2: or; Vhigh=5 Vf=0
A3: schmitt
B1: bv; V=5-V(DCC_IN)
C1: cap; 10n
C2: cap; 10n
C3: cap; 22n
C4: cap; 100n
R1: res; 15
R2: res; 100m
R3: res; 24k
R4: res; 1k
R5: res; 4.7k
R6: res; 1k
U1: L6203
V1: voltage; 18
V2: voltage; 5
V3: voltage; PULSE(0 5 0 10n 10n 58u 116u)
Named nets: 0, Fahrstrom, 5V, DCC_IN, DCC_Inv, Enable, Trip_Signal, V_Reset, SENSE_FILT
.include CustomComponents/L6203.lib
.tran 2m
