h07jonas/SYNCHRO/Hardware/LTSpice/SYNCHRO_Booster.asc

C1: cap; 100n
C2: cap; 470u
C3: cap; 470u
C4: cap; 10n
C5: cap; 22nF 50V
C6: cap; 22nF 50V
C7: cap; 22nF 50V
C8: cap; 10uF 50V
C9: cap; 100n
C10: cap; 100n
C11: cap; 100n
C12: cap; 100n
D1: diode; __D1
D2: diode; __D2
D4: diode; LED
D5: diode; LED
R1: res; 100m
R2: res; 1k
R3: res; 24k
R4: res; 1k
R5: res; 4.7k
R6: res; 10
R7: res; 1.2k
R8: res; 1.2k
R9: res; 4.7k
R10: res; 4.7k
R11: res; 10k
R12: res; 1k
R13: res; 1k
Named nets: /SENSE, GND1, +5V, +15V, NET-_D3-A1_, NET-_D3-A2_, NET-_C7-PAD2_, GND_Z, NET-_D1-K_, NET-_D2-K_, NET-_D4-A_, NET-_D5-A_, NET-_IC1-SENSE_, NET-_U1-1IN-_
.tran 10m
.include Custom_Models.lib
