h07jonas/SYNCHRO/Hardware/SYNCHRO_Booster/v3.0/SYNCHRO_Booster.kicad_pcb

## KiCad design Hardware/SYNCHRO_Booster/v3.0/SYNCHRO_Booster.kicad_pcb (2026-11-03)

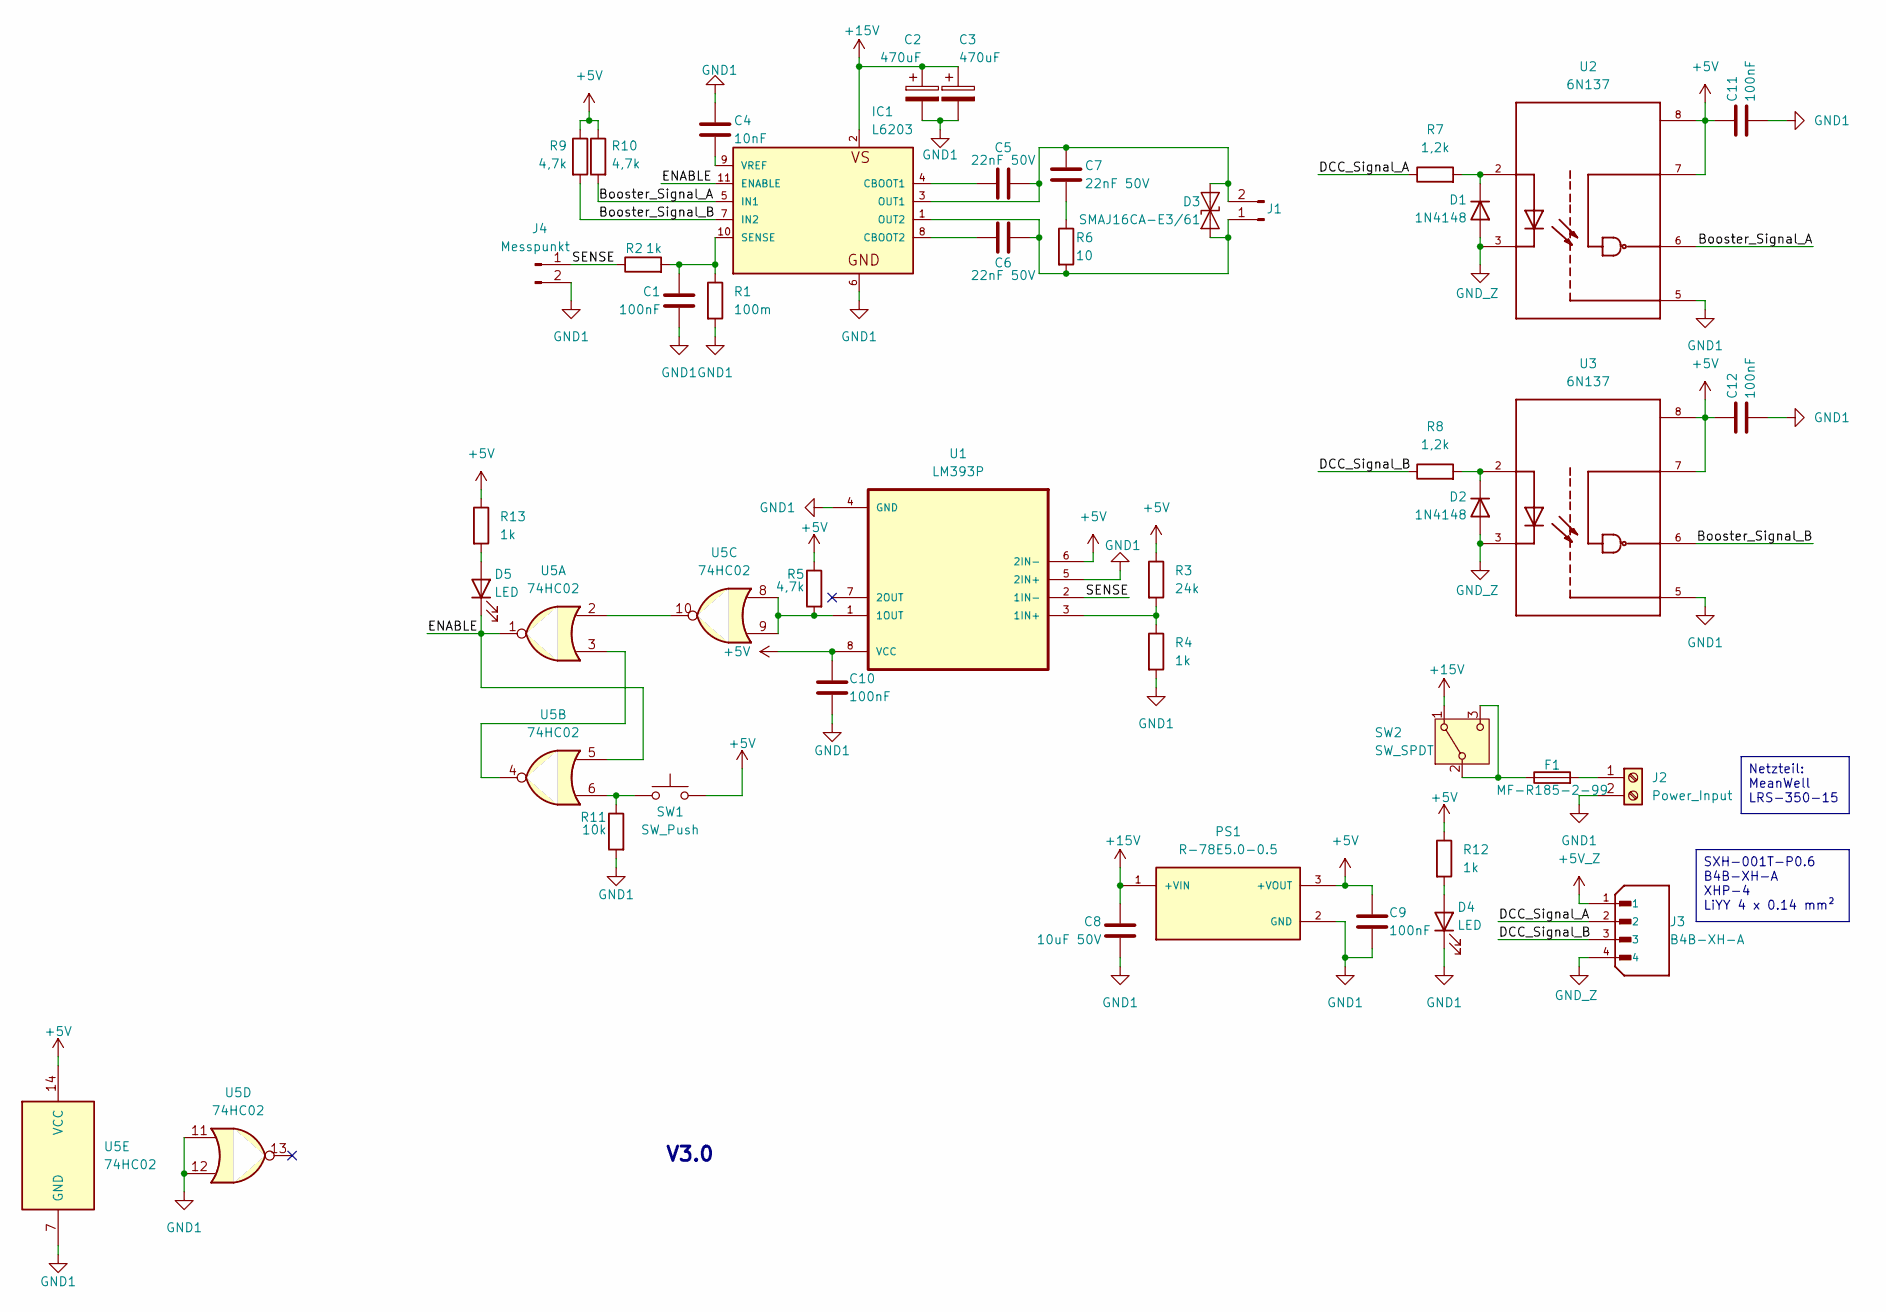
[picture p19: schematic SYNCHRO_Booster.kicad_sch]

Parts:
C1, C9, C10, C11, C12: 100nF; C_0603_1608Metric_Pad1.08x0.95mm_HandSolder
C2, C3: 470uF; CP_Radial_D10.0mm_P5.00mm
C4: 10nF; C_Disc_D5.0mm_W2.5mm_P5.00mm
C5, C6, C7: 22nF 50V; C_Rect_L7.0mm_W2.5mm_P5.00mm
C8: 10uF 50V; C_Rect_L7.0mm_W2.5mm_P5.00mm
D1, D2: 1N4148; D_DO-35_SOD27_P7.62mm_Horizontal
D3: SMAJ16CA-E3/61; D_SMA-SMB_Universal_Handsoldering
D4, D5: LED; LED_D5.0mm
F1: MF-R185-2-99; Fuse_Bourns_MF-R185
IC1: L6203; MULTIWATT-11; MPN L6203
J1: Conn_01x02_Pin; TerminalBlock_Phoenix_MKDS-1,5-2-5.08_1x02_P5.08mm_Horizont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
J2: Power_Input; TerminalBlock_Phoenix_MKDS-1,5-2-5.08_1x02_P5.08mm_Horizont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
J3: B4B-XH-A; JST_B4B-XH-A_LF__SN_
J4: Messpunkt; PinHeader_1x02_P2.54mm_Vertical
PS1: R-78E5.0-0.5; CONV_R-78E5.0-0.5; PARTREV 4
R1: 100m; R_2512_6332Metric_Pad1.40x3.35mm_HandSolder
R2, R4, R12, R13: 1k; R_0805_2012Metric_Pad1.20x1.40mm_HandSolder
R3: 24k; R_0805_2012Metric_Pad1.20x1.40mm_HandSolder
R5, R9, R10: 4,7k; R_0805_2012Metric_Pad1.20x1.40mm_HandSolder
R6: 10; R_0805_2012Metric_Pad1.20x1.40mm_HandSolder
R7, R8: 1,2k; R_0805_2012Metric_Pad1.20x1.40mm_HandSolder
R11: 10k; R_0805_2012Metric_Pad1.20x1.40mm_HandSolder
SW1: SW_Push; SW_PUSH_6mm
SW2: SW_SPDT; TerminalBlock_Phoenix_MKDS-3-3-5.08_1x03_P5.08mm_Horizontal
U1: LM393P; DIP762W50P254L977H451Q8
U2, U3: 6N137; DIP762W50P254L977H451Q8
U5: 74HC02; DIP-14_W7.62mm_LongPads

Connections:
+5V: C9.1, C10.1, C11.1, C12.1, PS1.3 (+VOUT), R3.1, R5.1, R9.1, R10.1, R12.1, R13.1, SW1.1, U1.6 (2IN-), U1.8 (VCC), U2.7, U2.8, U3.7, U3.8, U5.14 (VCC)
+5V_Z: J3.1
+15V: C2.1, C3.1, C8.1, IC1.2, PS1.1 (+VIN), SW2.1 (A)
/Booster_Signal_A: IC1.5 (IN1), R10.2, U2.6
/Booster_Signal_B: IC1.7 (IN2), R9.2, U3.6
/DCC_Signal_A: J3.2, R7.1
/DCC_Signal_B: J3.3, R8.1
/ENABLE: D5.1 (K), IC1.11 (ENABLE), U5.1, U5.5
/SENSE: J4.1, R2.1, U1.2 (1IN-)
GND1: C1.2, C2.2, C3.2, C4.1, C8.2, C9.2, C10.2, C11.2, C12.2, D4.1 (K), IC1.6, J2.2, J4.2, PS1.2 (GND), R1.2, R4.2, R11.2, U1.4 (GND), U1.5 (2IN+), U2.5, U3.5, U5.7 (GND), U5.11, U5.12
GND_Z: D1.2 (A), D2.2 (A), J3.4, U2.3, U3.3
unnamed: C7.2, R6.1
unnamed: D1.1 (K), R7.2, U2.2
unnamed: D2.1 (K), R8.2, U3.2
unnamed: C5.2, C7.1, D3.1 (A1), IC1.3 (OUT1), J1.2
unnamed: C6.1, D3.2 (A2), IC1.1 (OUT2), J1.1, R6.2
unnamed: D4.2 (A), R12.2
unnamed: D5.2 (A), R13.2
unnamed: C5.1, IC1.4 (CBOOT1)
unnamed: C6.2, IC1.8 (CBOOT2)
unnamed: C1.1, IC1.10 (SENSE), R1.1, R2.2
unnamed: C4.2, IC1.9 (VREF)
unnamed: F1.2, J2.1
unnamed: R11.1, SW1.2, U5.6
unnamed: F1.1, SW2.2 (B), SW2.3 (C)
unnamed: R3.2, R4.1, U1.3 (1IN+)
unnamed: R5.2, U1.1 (1OUT), U5.8, U5.9
unnamed: U5.3, U5.4
unnamed: U5.2, U5.10

Notes on the sheet:
V3.0
Netzteil: MeanWell LRS-350-15
SXH-001T-P0.6 B4B-XH-A XHP-4 LiYY 4 x 0.14 mm²

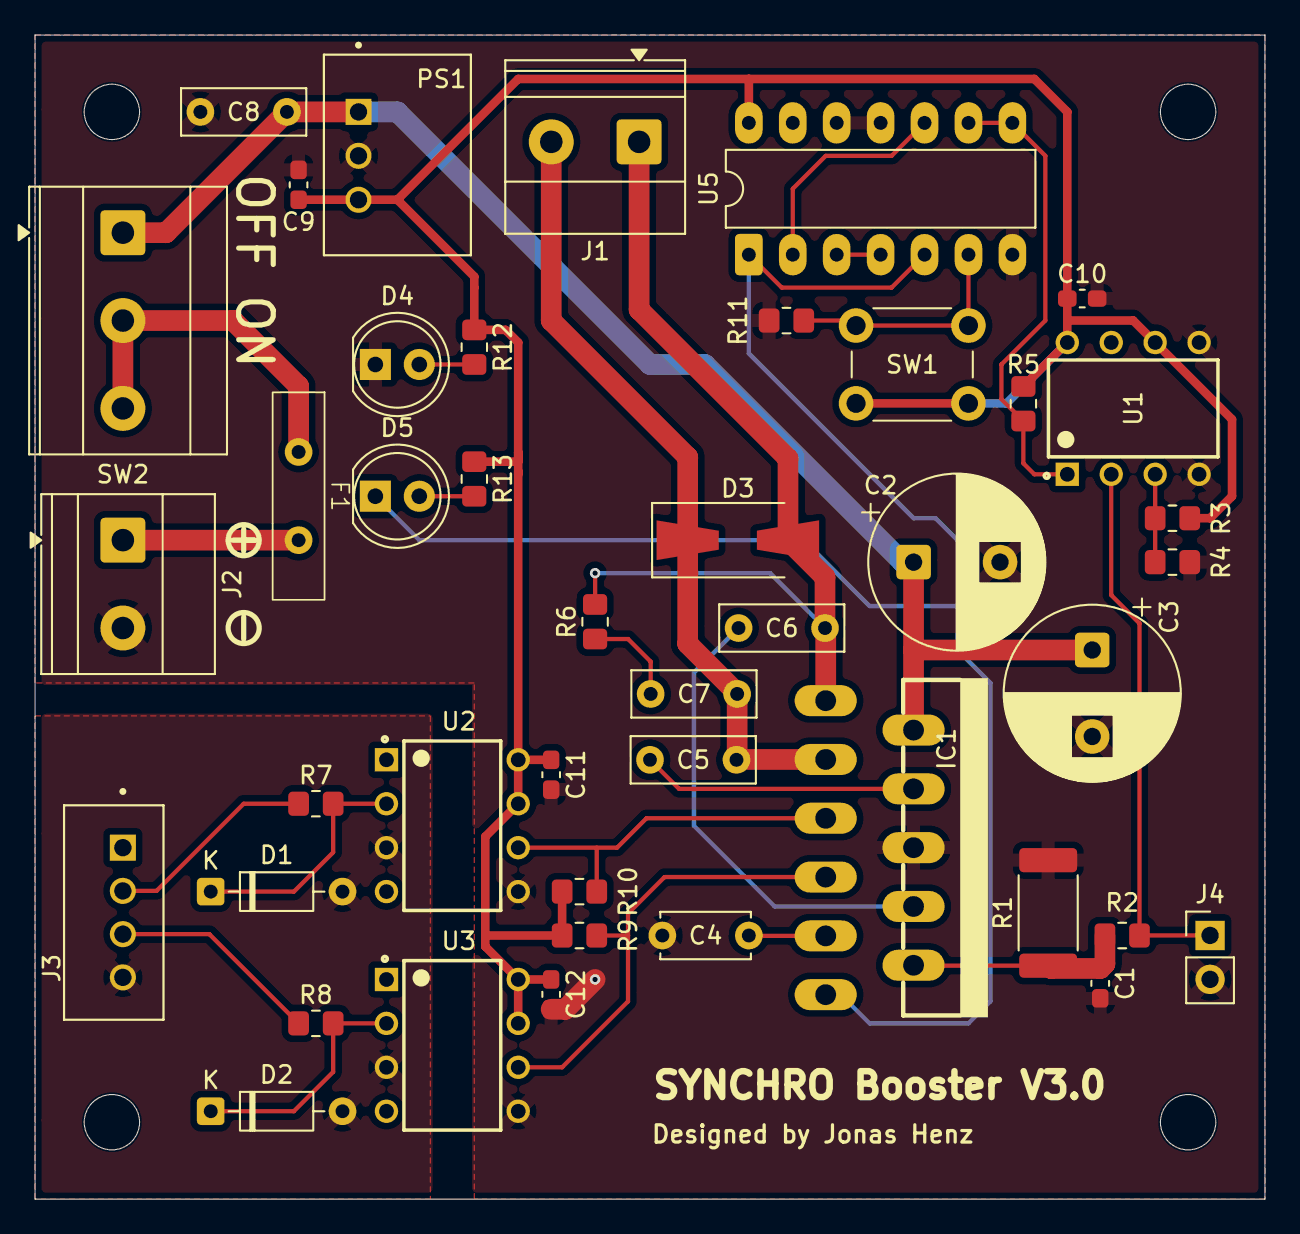
[picture p20: board Hardware/SYNCHRO_Booster/v3.0/SYNCHRO_Booster.kicad_pcb from above]

Board: 2 copper layers, 71.1 x 67.3 mm, 43 parts (0 on the bottom side), 28 nets.
