h07jonas/SYNCHRO/Hardware/SYNCHRO_Booster/v2.0_FlipFlop_only/SYNCHRO_Booster.kicad_pcb

## KiCad design Hardware/SYNCHRO_Booster/v2.0_FlipFlop_only/SYNCHRO_Booster.kicad_pcb (2026-10-20)

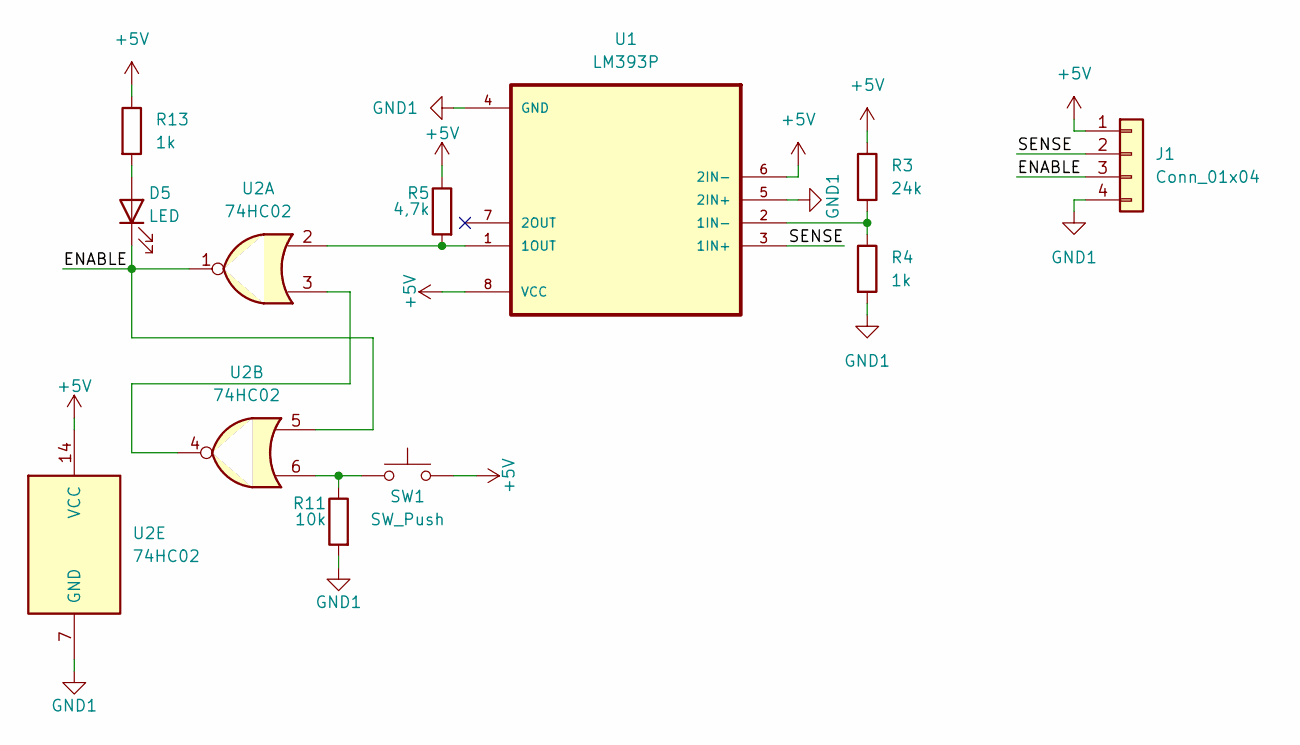
[picture p21: schematic SYNCHRO_Booster.kicad_sch]

Parts:
D5: LED; LED_D5.0mm
J1: Conn_01x04; PinSocket_1x04_P2.54mm_Vertical
R3: 24k; R_Axial_DIN0204_L3.6mm_D1.6mm_P7.62mm_Horizontal
R4, R13: 1k; R_Axial_DIN0204_L3.6mm_D1.6mm_P7.62mm_Horizontal
R5: 4,7k; R_Axial_DIN0204_L3.6mm_D1.6mm_P7.62mm_Horizontal
R11: 10k; R_Axial_DIN0204_L3.6mm_D1.6mm_P7.62mm_Horizontal
SW1: SW_Push; SW_PUSH_6mm
U1: LM393P; DIP762W50P254L977H451Q8
U2: 74HC02; DIP-14_W10.16mm_LongPads

Connections:
+5V: J1.1, R3.1, R5.1, R13.1, SW1.1, U1.6 (2IN-), U1.8 (VCC), U2.14 (VCC)
/ENABLE: D5.1 (K), J1.3, U2.1, U2.5
/SENSE: J1.2, U1.3 (1IN+)
GND1: J1.4, R4.2, R11.2, U1.4 (GND), U1.5 (2IN+), U2.7 (GND)
unnamed: D5.2 (A), R13.2
unnamed: R11.1, SW1.2, U2.6
unnamed: R3.2, R4.1, U1.2 (1IN-)
unnamed: R5.2, U1.1 (1OUT), U2.2
unnamed: U2.3, U2.4

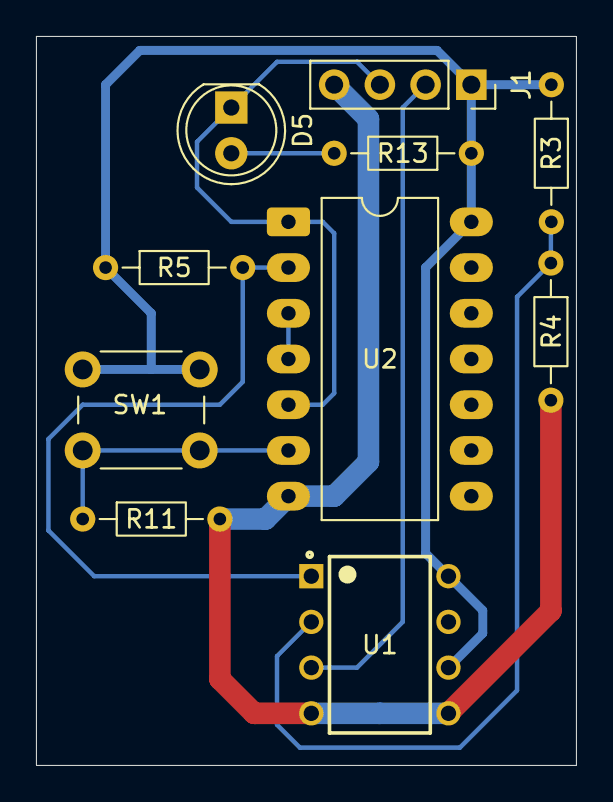
[picture p22: board Hardware/SYNCHRO_Booster/v2.0_FlipFlop_only/SYNCHRO_Booster.kicad_pcb from above]

Board: 2 copper layers, 30.0 x 40.5 mm, 10 parts (0 on the bottom side), 9 nets.
