h07jonas/SYNCHRO/Hardware/SYNCHRO_Zentrale/SYNCHRO_Zentrale.kicad_pcb

## KiCad design Hardware/SYNCHRO_Zentrale/SYNCHRO_Zentrale.kicad_pcb (2026-09-01)

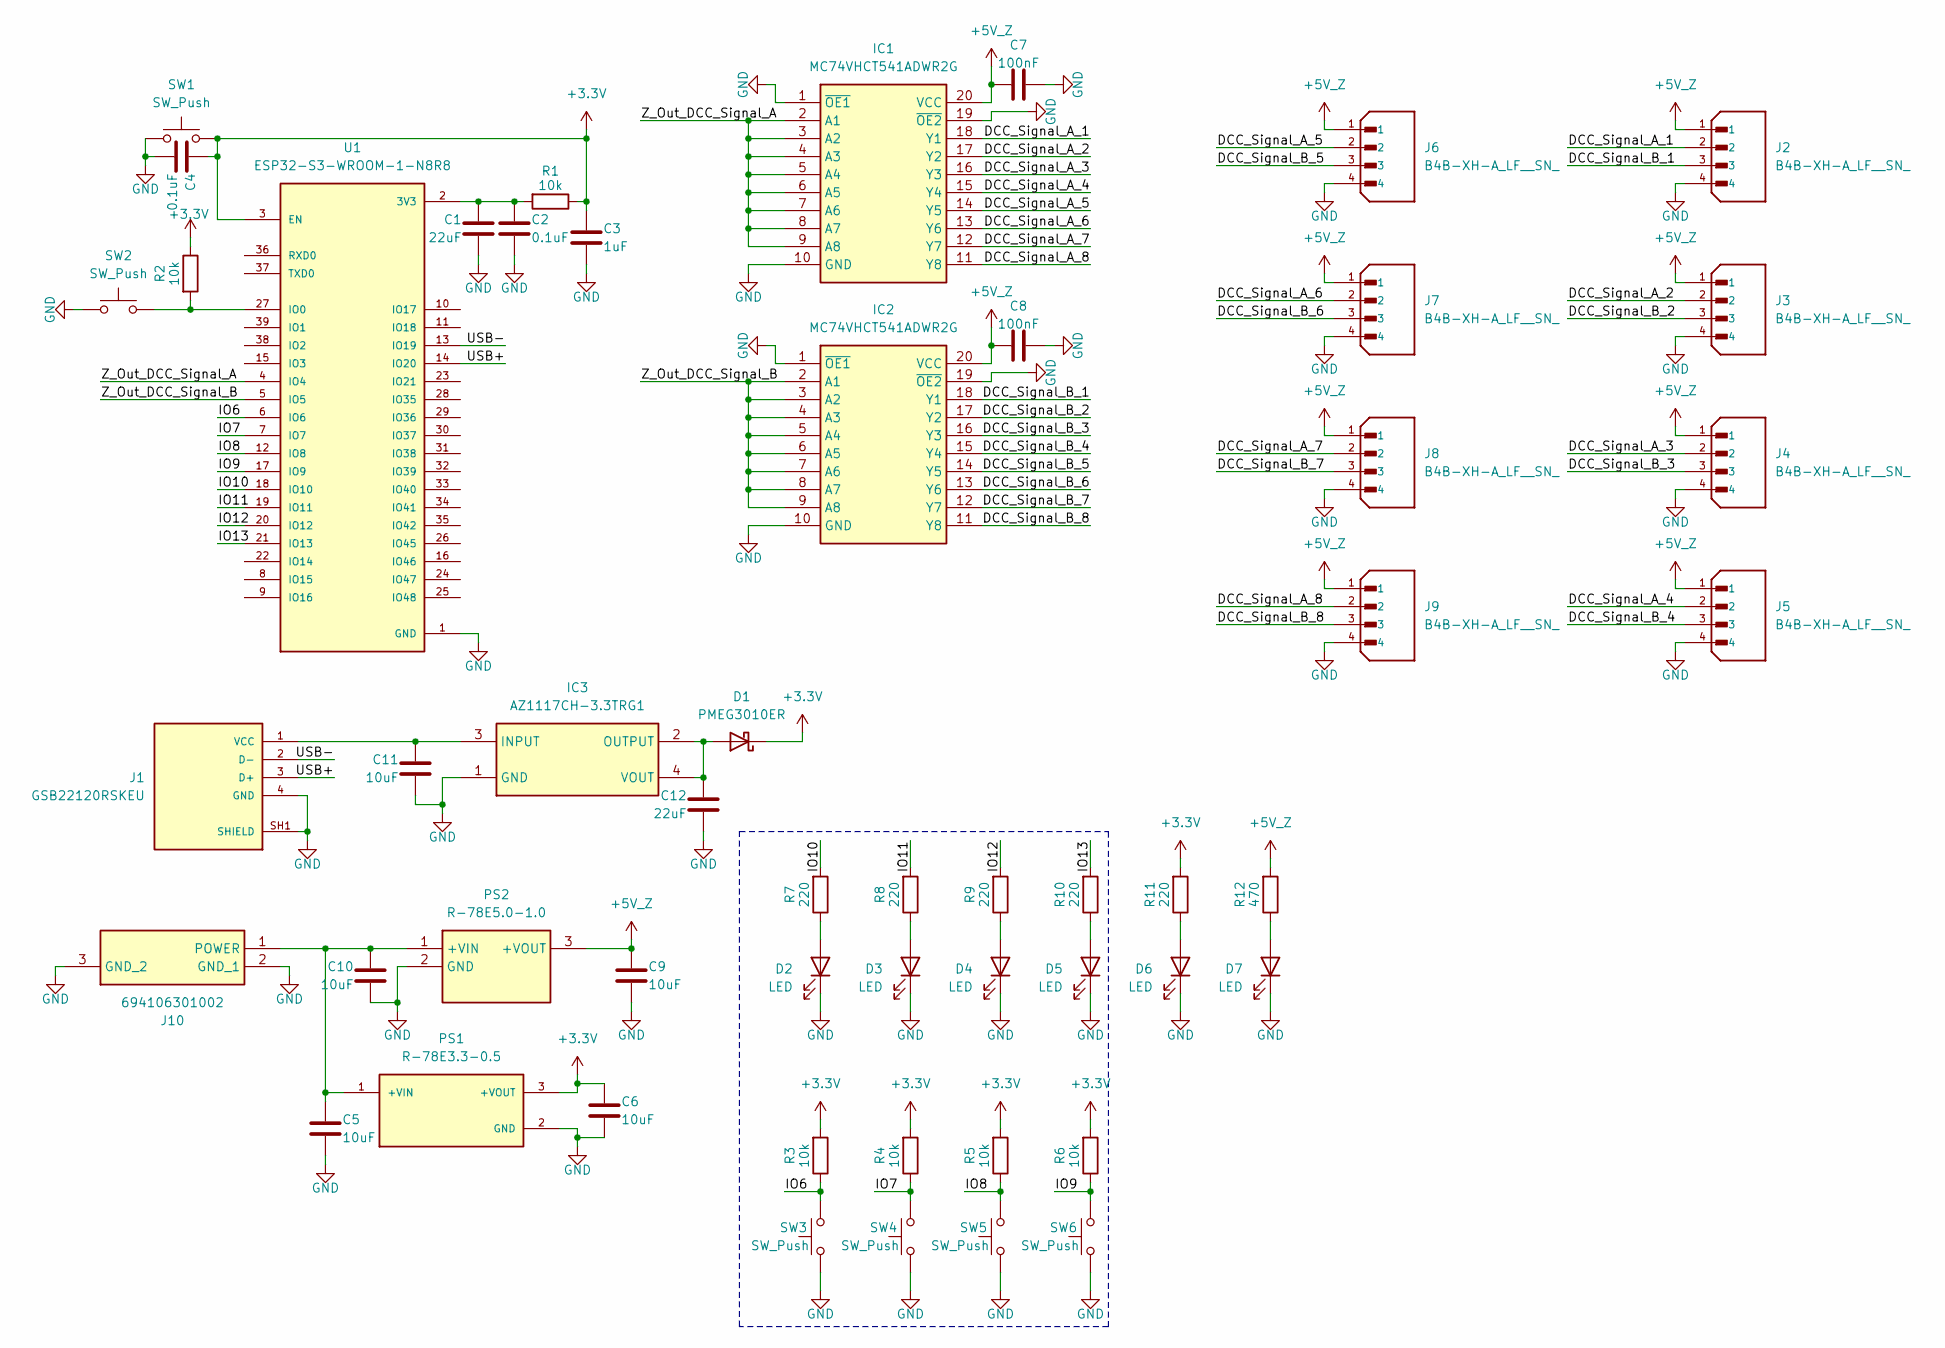
[picture p23: schematic SYNCHRO_Zentrale.kicad_sch]

Parts:
C1, C12: 22uF; C_1210_3225Metric_Pad1.33x2.70mm_HandSolder
C2, C4: 0.1uF; C_1206_3216Metric_Pad1.33x1.80mm_HandSolder
C3: 1uF; C_1206_3216Metric_Pad1.33x1.80mm_HandSolder
C5, C6, C9, C10, C11: 10uF; C_1210_3225Metric_Pad1.33x2.70mm_HandSolder
C7, C8: 100nF; C_1206_3216Metric_Pad1.33x1.80mm_HandSolder
D1: PMEG3010ER; Nexperia_CFP3_SOD-123W
D2, D3, D4, D5, D6, D7: LED; LED_D5.0mm
IC1, IC2: MC74VHCT541ADWR2G; SOIC127P1030X265-20N; Manufacturer_Part_Number MC74VHCT541ADWR2G
IC3: AZ1117CH-3.3TRG1; SOT230P700X180-4N; Mouser Part Number 621-AZ1117CH-3.3TRG1
J1: GSB22120RSKEU; AMPHENOL_GSB22120RSKEU; PARTREV E
J2, J3, J4, J5, J6, J7, J8, J9: B4B-XH-A_LF__SN_; JST_B4B-XH-A_LF__SN_
J10: 694106301002; Mouser Part Number 710-694106301002
PS1: R-78E3.3-0.5; CONV_R-78E3.3-0.5; PARTREV 4
PS2: R-78E5.0-1.0; R78E5010; Mouser Part Number 919-R-78E5.0-1.0
R1, R2, R3, R4, R5, R6: 10k; R_0805_2012Metric_Pad1.20x1.40mm_HandSolder
R7, R8, R9, R10, R11: 220; R_0805_2012Metric_Pad1.20x1.40mm_HandSolder
R12: 470; R_0805_2012Metric_Pad1.20x1.40mm_HandSolder
SW1, SW2, SW3, SW4, SW5, SW6: SW_Push; SW_PUSH_6mm
U1: ESP32-S3-WROOM-1-N8R8; ESP32S3WROOM1N8R8

Connections:
+3.3V: C3.1, C4.1, C6.1, D1.1 (K), PS1.3 (+VOUT), R1.1, R2.1, R3.2, R4.2, R5.2, R6.2, R11.2, SW1.2, U1.3 (EN)
+5V_Z: C7.1, C8.1, C9.1, IC1.20 (VCC), IC2.20 (VCC), J2.1, J3.1, J4.1, J5.1, J6.1, J7.1, J8.1, J9.1, PS2.3 (+VOUT), R12.2
/DCC_Signal_A_1: IC1.18 (Y1), J2.2
/DCC_Signal_A_2: IC1.17 (Y2), J3.2
/DCC_Signal_A_3: IC1.16 (Y3), J4.2
/DCC_Signal_A_4: IC1.15 (Y4), J5.2
/DCC_Signal_A_5: IC1.14 (Y5), J6.2
/DCC_Signal_A_6: IC1.13 (Y6), J7.2
/DCC_Signal_A_7: IC1.12 (Y7), J8.2
/DCC_Signal_A_8: IC1.11 (Y8), J9.2
/DCC_Signal_B_1: IC2.18 (Y1), J2.3
/DCC_Signal_B_2: IC2.17 (Y2), J3.3
/DCC_Signal_B_3: IC2.16 (Y3), J4.3
/DCC_Signal_B_4: IC2.15 (Y4), J5.3
/DCC_Signal_B_5: IC2.14 (Y5), J6.3
/DCC_Signal_B_6: IC2.13 (Y6), J7.3
/DCC_Signal_B_7: IC2.12 (Y7), J8.3
/DCC_Signal_B_8: IC2.11 (Y8), J9.3
/IO6: R3.1, SW3.2, U1.6 (IO6)
/IO7: R4.1, SW4.2, U1.7 (IO7)
/IO8: R5.1, SW5.2, U1.12 (IO8)
/IO9: R6.1, SW6.2, U1.17 (IO9)
/IO10: R7.2, U1.18 (IO10)
/IO11: R8.2, U1.19 (IO11)
/IO12: R9.2, U1.20 (IO12)
/IO13: R10.2, U1.21 (IO13)
/USB+: J1.3 (D+), U1.14 (IO20)
/USB-: J1.2 (D-), U1.13 (IO19)
/Z_Out_DCC_Signal_A: IC1.2 (A1), IC1.3 (A2), IC1.4 (A3), IC1.5 (A4), IC1.6 (A5), IC1.7 (A6), IC1.8 (A7), IC1.9 (A8), U1.4 (IO4)
/Z_Out_DCC_Signal_B: IC2.2 (A1), IC2.3 (A2), IC2.4 (A3), IC2.5 (A4), IC2.6 (A5), IC2.7 (A6), IC2.8 (A7), IC2.9 (A8), U1.5 (IO5)
GND: C1.2, C2.2, C3.2, C4.2, C5.2, C6.2, C7.2, C8.2, C9.2, C10.2, C11.2, C12.2, D2.1 (K), D3.1 (K), D4.1 (K), D5.1 (K), D6.1 (K), D7.1 (K), IC1.1 (~OE1), IC1.10 (GND), IC1.19 (~OE2), IC2.1 (~OE1), IC2.10 (GND), IC2.19 (~OE2), IC3.1 (GND), J1.4 (GND), J1.SH1 (SHIELD), J1.SH2 (SHIELD), J2.4, J3.4, J4.4, J5.4, J6.4, J7.4, J8.4, J9.4, J10.2 (GND_1), J10.3 (GND_2), PS1.2 (GND), PS2.2 (GND), SW1.1, SW2.1, SW3.1, SW4.1, SW5.1, SW6.1, U1.1 (GND), U1.40 (GND), U1.41_1 (GND), U1.41_2 (GND), U1.41_3 (GND), U1.41_4 (GND), U1.41_5 (GND), U1.41_6 (GND), U1.41_7 (GND), U1.41_8 (GND), U1.41_9 (GND)
unnamed: C12.1, D1.2 (A), IC3.2 (OUTPUT), IC3.4 (VOUT)
unnamed: D2.2 (A), R7.1
unnamed: D3.2 (A), R8.1
unnamed: D4.2 (A), R9.1
unnamed: D5.2 (A), R10.1
unnamed: D6.2 (A), R11.1
unnamed: D7.2 (A), R12.1
unnamed: C11.1, IC3.3 (INPUT), J1.1 (VCC)
unnamed: C5.1, C10.1, J10.1 (POWER), PS1.1 (+VIN), PS2.1 (+VIN)
unnamed: C1.1, C2.1, R1.2, U1.2 (3V3)
unnamed: R2.2, SW2.2, U1.27 (IO0)

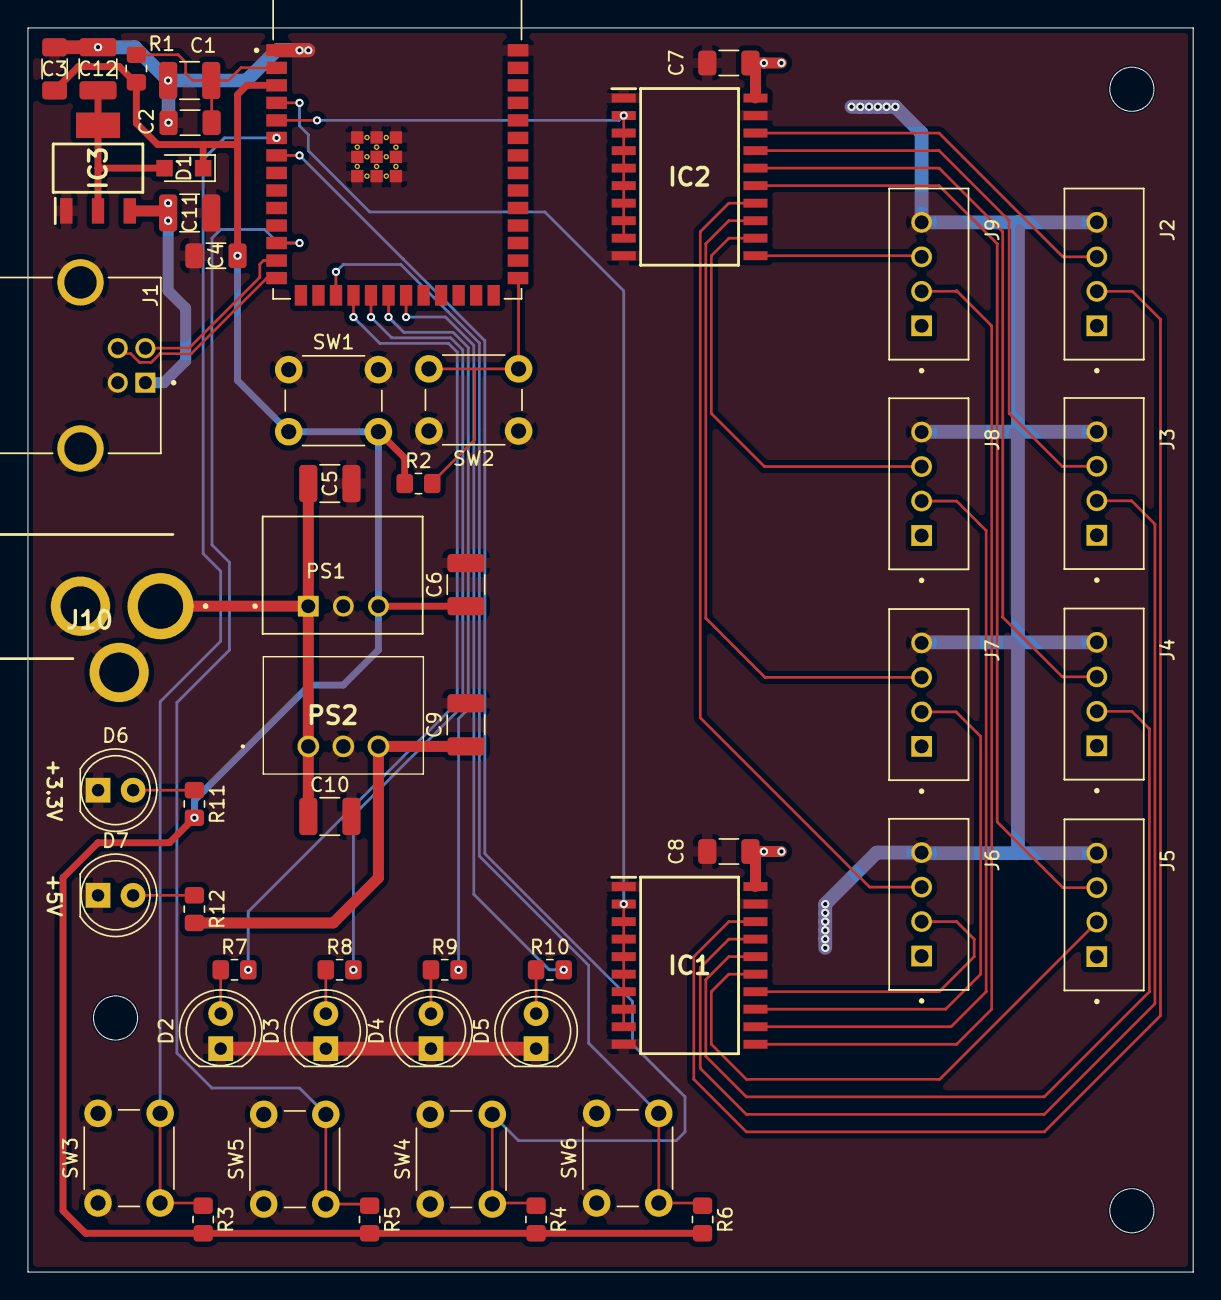
[picture p24: board SYNCHRO_Zentrale.kicad_pcb from above]

Board: 2 copper layers, 84.5 x 90.2 mm, 53 parts (0 on the bottom side), 42 nets.
