h07jonas/SYNCHRO/(commit log)

2026-06-12 Fix: .gitkeep Platzhalter fuer Software, Docs und Datasheets hinzugefuegt
2026-06-12 kicad-library push
2026-06-21 Booster Schematic Update
2026-10-20 updating Booster PCB to V3.0 (new footprints, layout changes and current sense redesign)
2026-11-03 V3.0 Design and finallisierungen, Gerber Export
